juniortada/kossel-dragon-burner/images/effector_baixo.png

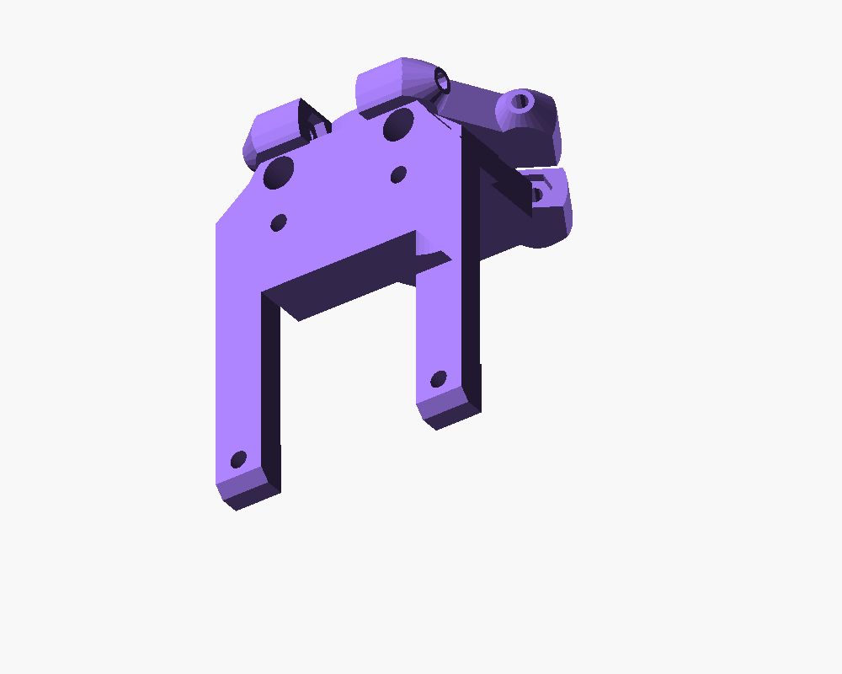
images/effector_baixo.png
