juniortada/kossel-dragon-burner/images/effector_cima.png

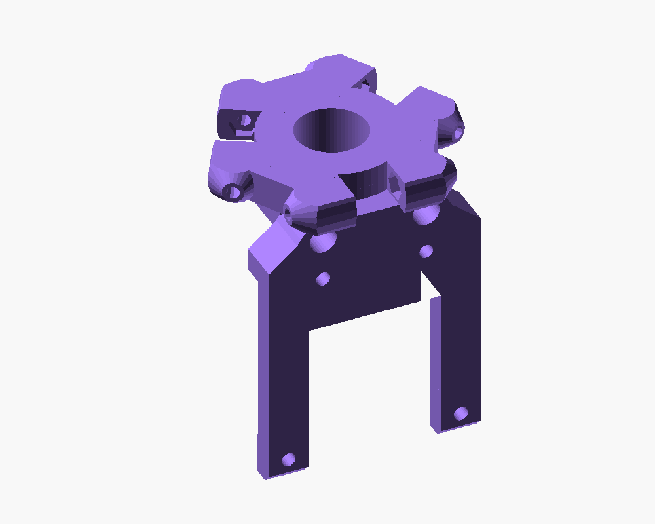
images/effector_cima.png
