juniortada/kossel-dragon-burner/images/impressao.png

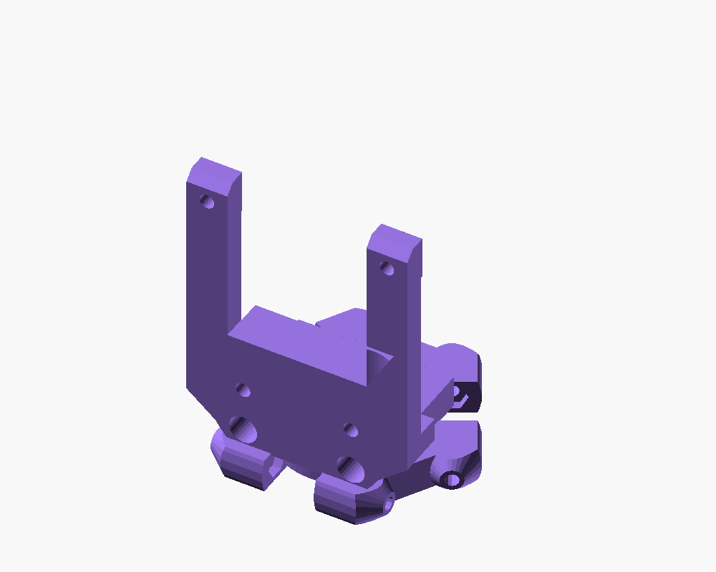
images/impressao.png
