juniortada/kossel-dragon-burner/parts/dragon_burner_bltouch_right.stl

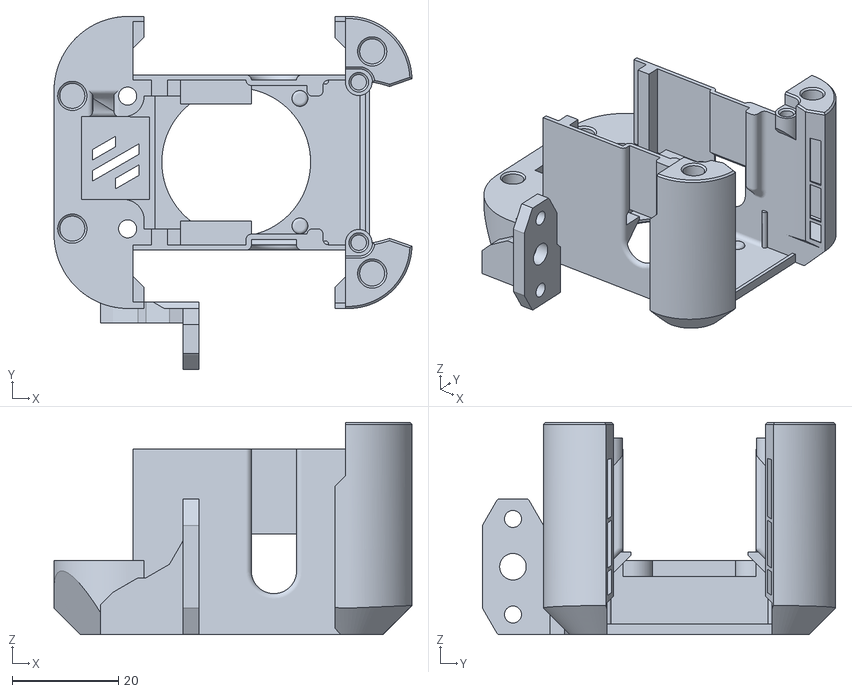
[picture p6: CAD file, 2026-11-02]
parts/dragon_burner_bltouch_right.stl
67.4 x 66.5 x 40.0
