juniortada/kossel-dragon-burner/parts/step/root__G2SA_Sherpa_Mount.stl

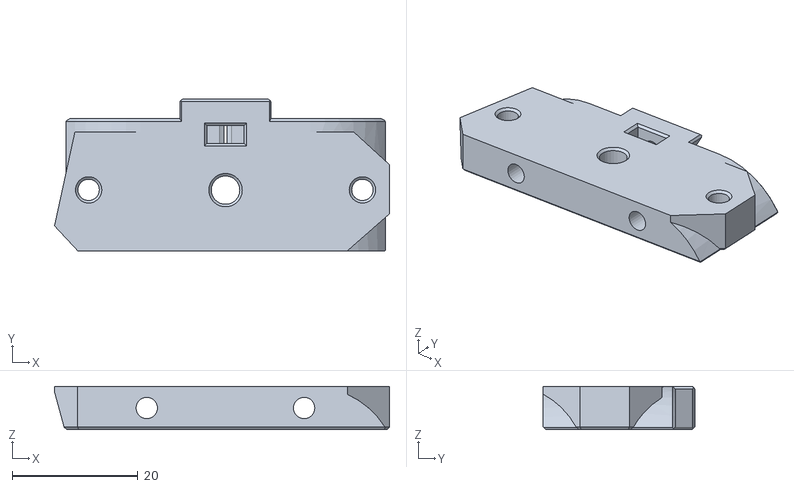
[picture p7: CAD file, 2026-11-02]
parts/step/root__G2SA_Sherpa_Mount.stl
53.2 x 24.1 x 6.90
