juniortada/kossel-dragon-burner/stl/effector_dragon_burner.stl

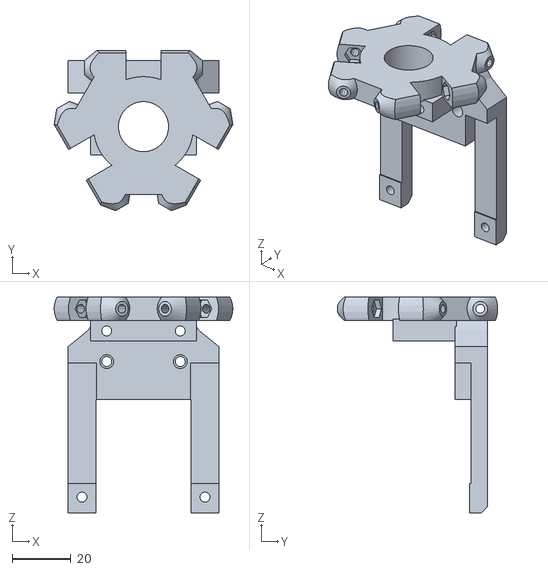
[picture p8: CAD file, 2026-11-02]
stl/effector_dragon_burner.stl
60.7 x 54.5 x 73.4
