juniortada/kossel-dragon-burner/parts/dragon_burner_bltouch_left.stl

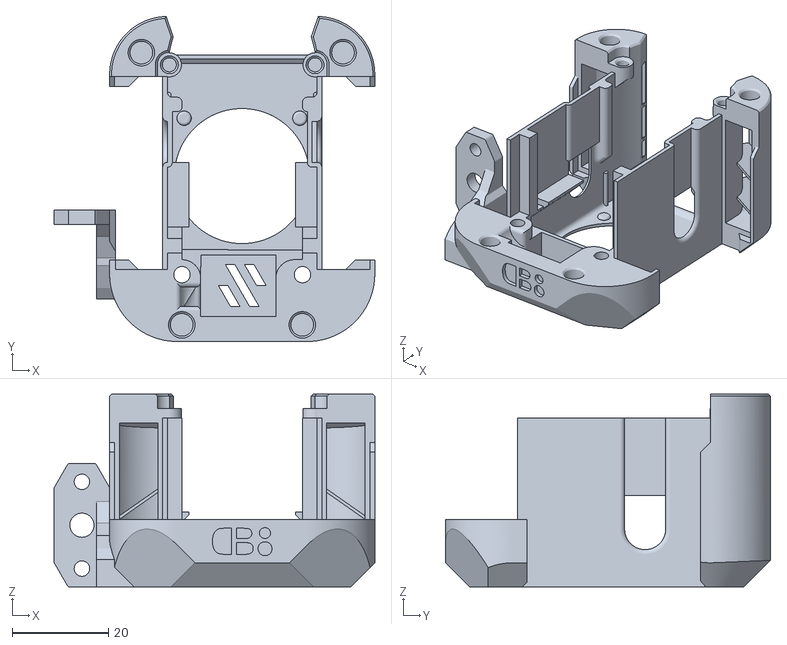
[picture p9: CAD file, 2026-11-02]
parts/dragon_burner_bltouch_left.stl
66.5 x 67.4 x 40.0
