juniortada/kossel-dragon-burner/parts/step/root__LGX_Lite_Mount.stl

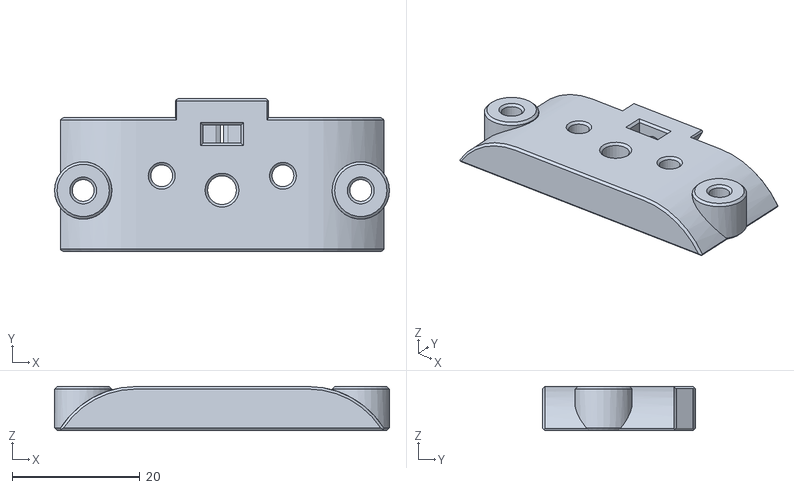
[picture p10: CAD file, 2026-11-02]
parts/step/root__LGX_Lite_Mount.stl
52.5 x 24.0 x 6.90
