juniortada/kossel-dragon-burner/parts/step/DFA_Mounts__Dragon_Mount_1.stl

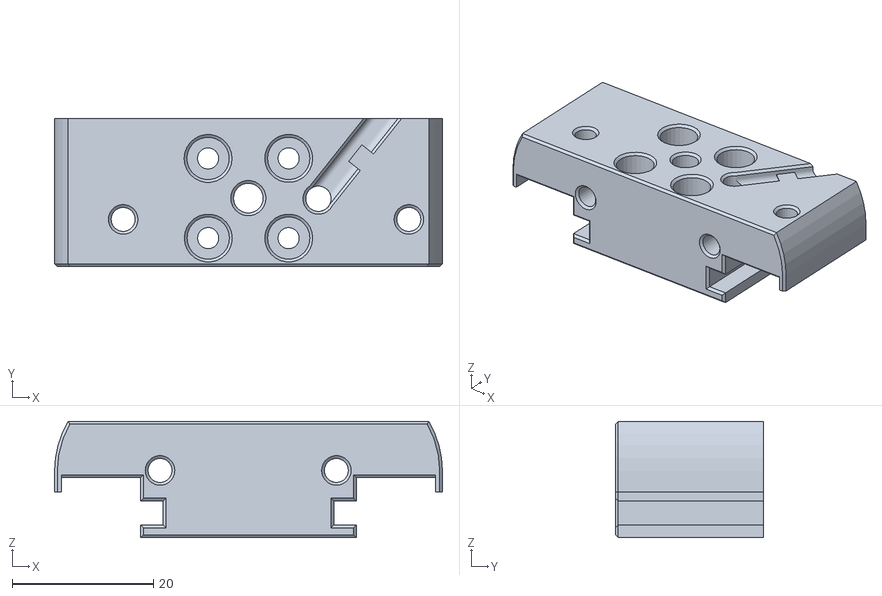
[picture p11: CAD file, 2026-11-02]
parts/step/DFA_Mounts__Dragon_Mount_1.stl
55.0 x 21.0 x 16.5
