juniortada/kossel-dragon-burner/stl/effector_dragon_burner_pc4_m10.stl

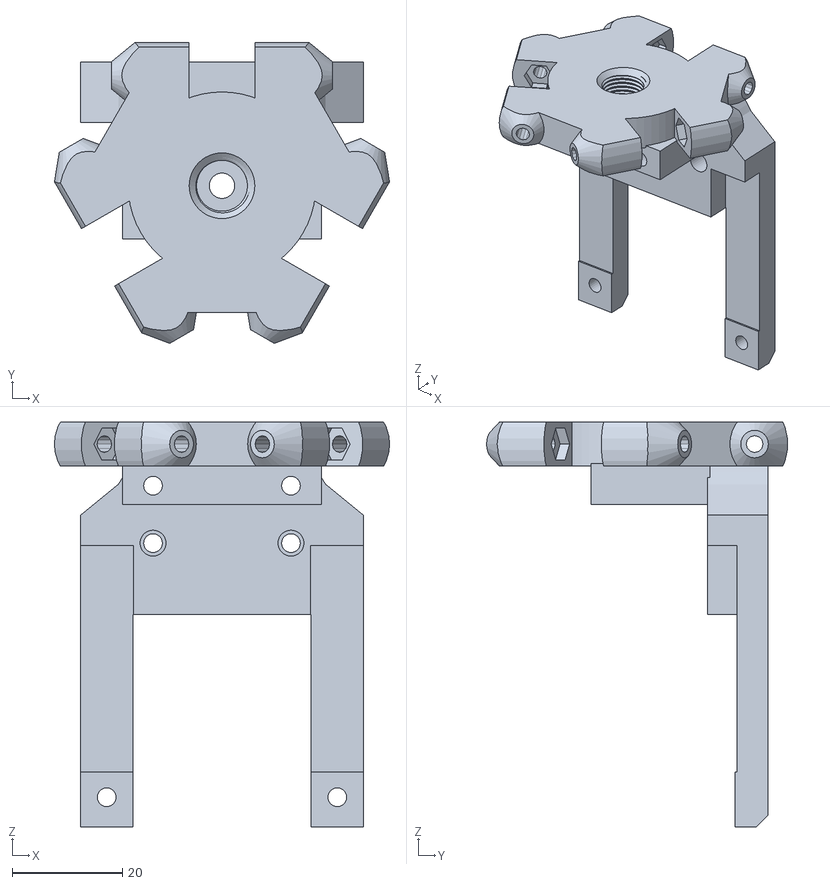
[picture p12: CAD file, 2026-11-02]
stl/effector_dragon_burner_pc4_m10.stl
60.7 x 54.5 x 73.4
