juniortada/kossel-dragon-burner/parts/step/Orbiter1.5_Mounts__V6_Mount_Front_1.stl

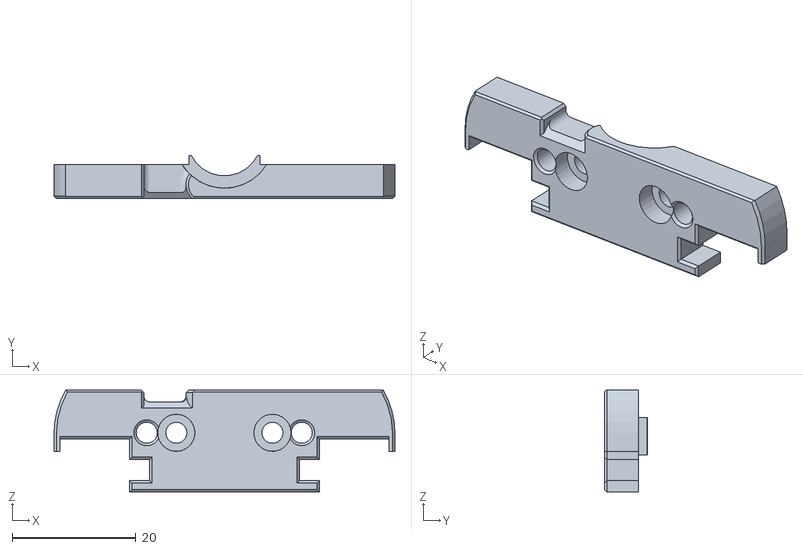
[picture p13: CAD file, 2026-11-02]
parts/step/Orbiter1.5_Mounts__V6_Mount_Front_1.stl
55.0 x 6.99 x 16.4
