juniortada/kossel-dragon-burner/parts/step/root__RoundTrip_Mount.stl

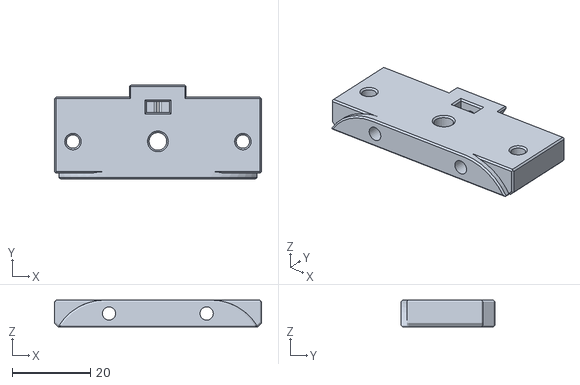
[picture p14: CAD file, 2026-11-02]
parts/step/root__RoundTrip_Mount.stl
53.0 x 24.1 x 6.90
