juniortada/kossel-dragon-burner/parts/step/Hotend_Mounts__V6_Mount_Rear.stl

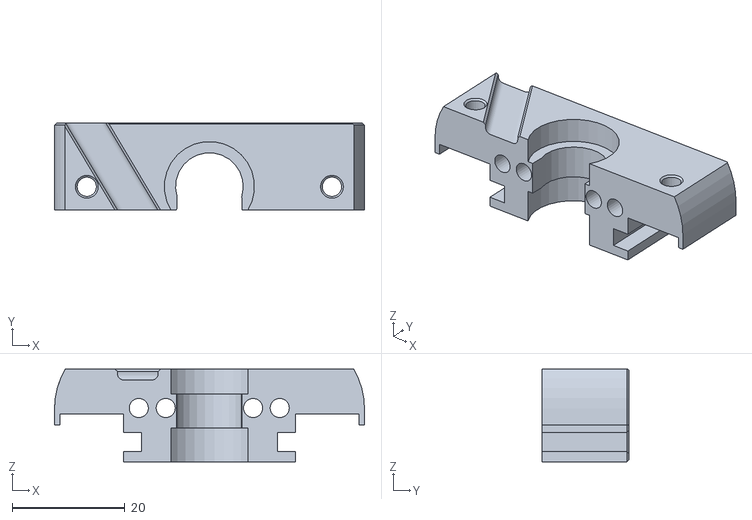
[picture p15: CAD file, 2026-11-02]
parts/step/Hotend_Mounts__V6_Mount_Rear.stl
55.0 x 15.5 x 16.4
