juniortada/kossel-dragon-burner/parts/step/Orbiter1.5_Mounts__Orbiter1.5_Mount_2.stl

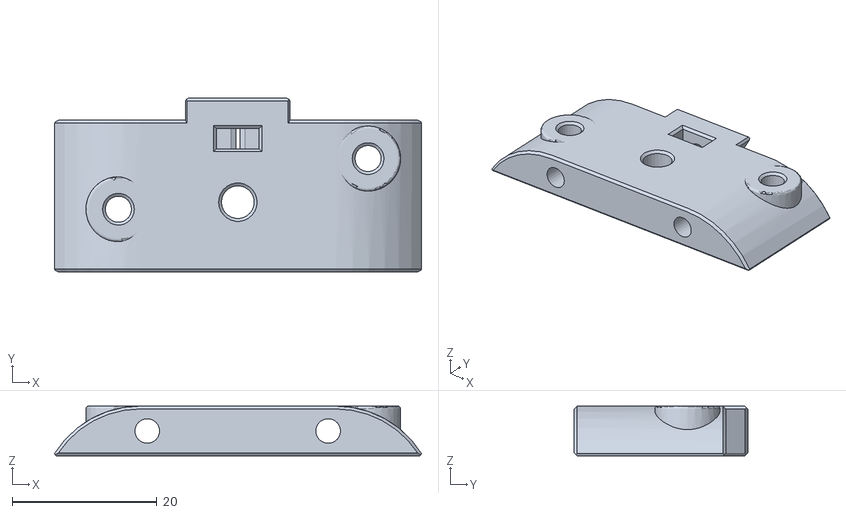
[picture p16: CAD file, 2026-11-02]
parts/step/Orbiter1.5_Mounts__Orbiter1.5_Mount_2.stl
50.7 x 24.0 x 6.90
