juniortada/kossel-dragon-burner/parts/step/Orbiter2_Mounts__RevoMicro_Mount.stl

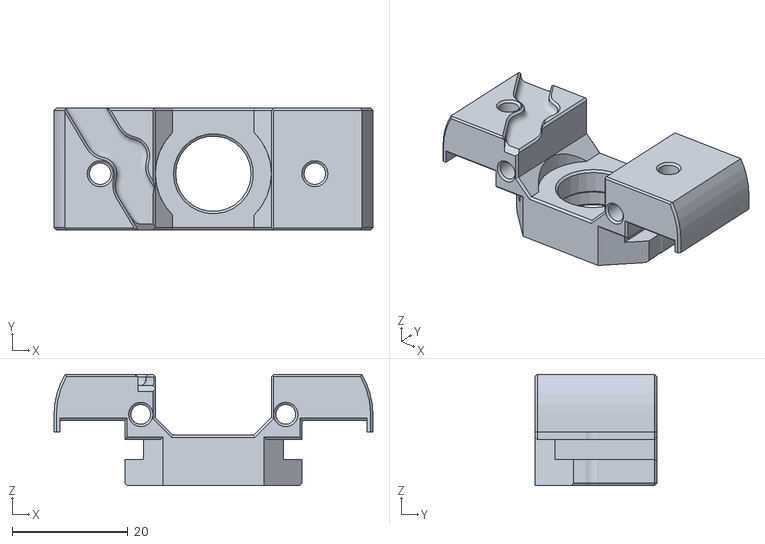
[picture p17: CAD file, 2026-11-02]
parts/step/Orbiter2_Mounts__RevoMicro_Mount.stl
55.0 x 21.0 x 19.1
