juniortada/kossel-dragon-burner/parts/step/Sherpa_Micro_Mounts__Sherpa_Micro_Mount.stl

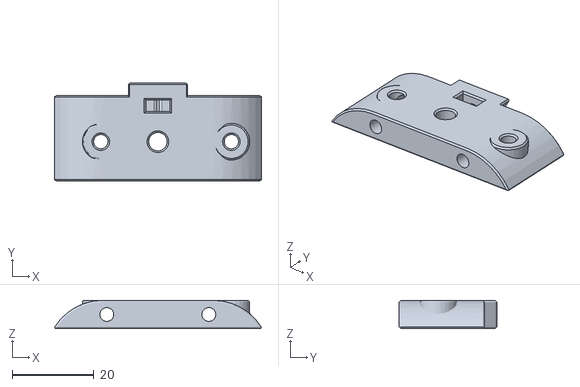
[picture p18: CAD file, 2026-11-02]
parts/step/Sherpa_Micro_Mounts__Sherpa_Micro_Mount.stl
50.7 x 24.0 x 6.90
