juniortada/kossel-dragon-burner/parts/step/root__Bowden_Mount_285.stl

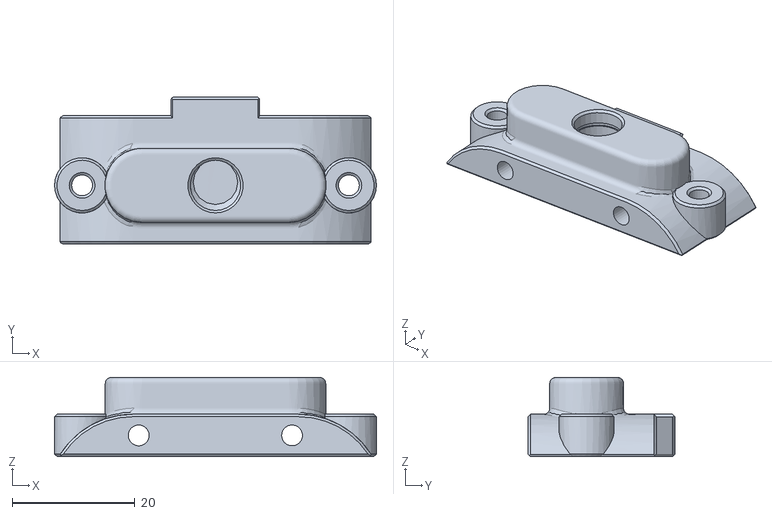
[picture p19: CAD file, 2026-11-02]
parts/step/root__Bowden_Mount_285.stl
52.5 x 24.0 x 12.9
