juniortada/kossel-dragon-burner/parts/step/root__WristWatch_BMG_Mount.stl

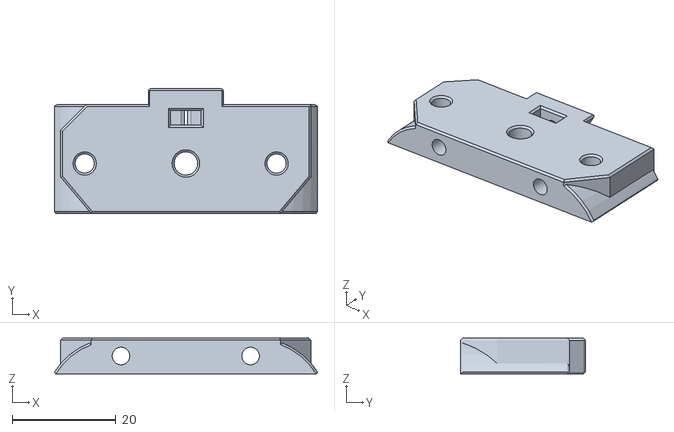
[picture p20: CAD file, 2026-11-02]
parts/step/root__WristWatch_BMG_Mount.stl
50.7 x 24.1 x 6.90
