juniortada/kossel-dragon-burner/parts/step/Orbiter1.5_Mounts__Dragon_Mount_2_1.stl

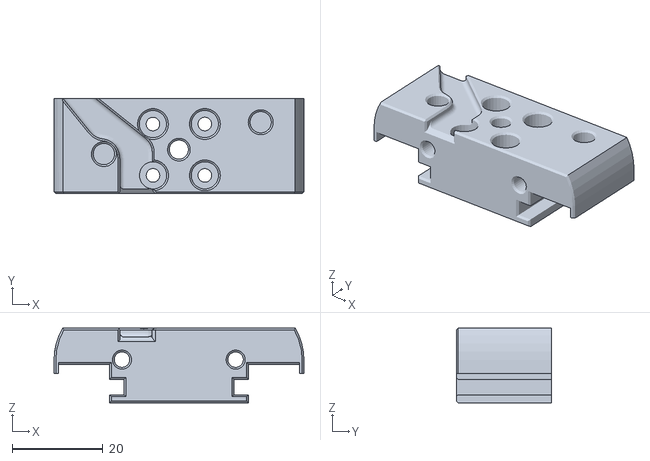
[picture p21: CAD file, 2026-11-02]
parts/step/Orbiter1.5_Mounts__Dragon_Mount_2_1.stl
55.0 x 21.0 x 16.5
