juniortada/kossel-dragon-burner/parts/step/root__Bowden_Mount_1.stl

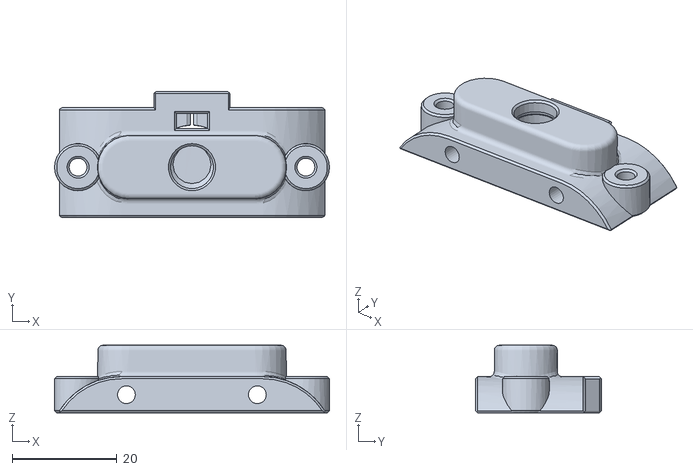
[picture p22: CAD file, 2026-11-02]
parts/step/root__Bowden_Mount_1.stl
52.5 x 24.0 x 12.9
