juniortada/kossel-dragon-burner/parts/step/root__Sherpa_Mini_Mount.stl

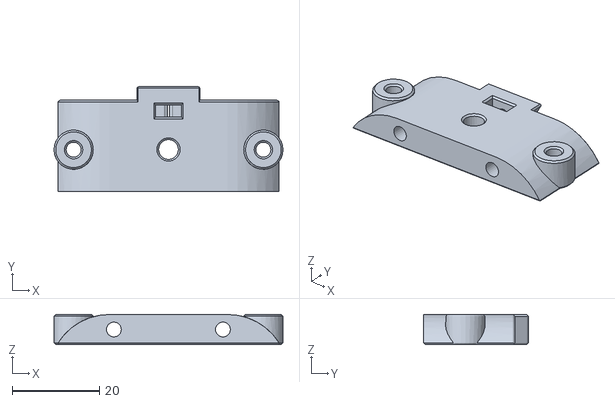
[picture p23: CAD file, 2026-11-02]
parts/step/root__Sherpa_Mini_Mount.stl
52.5 x 24.1 x 6.90
