juniortada/kossel-dragon-burner/parts/step/DFA_Mounts__DFA_Mount.stl

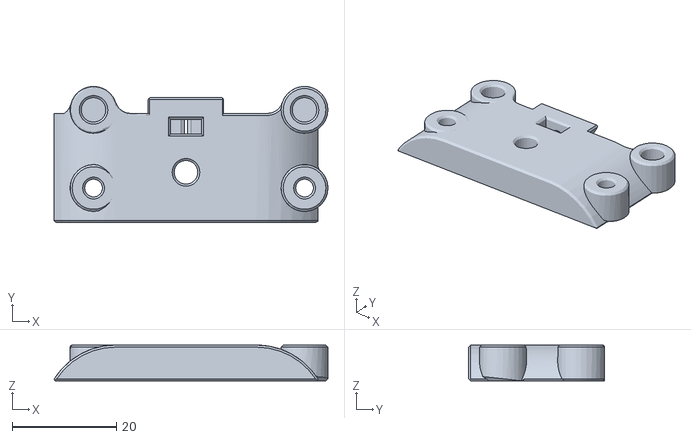
[picture p24: CAD file, 2026-11-02]
parts/step/DFA_Mounts__DFA_Mount.stl
52.6 x 26.1 x 6.90
