juniortada/kossel-dragon-burner/parts/step/Hotend_Mounts__Dragon_Mount.stl

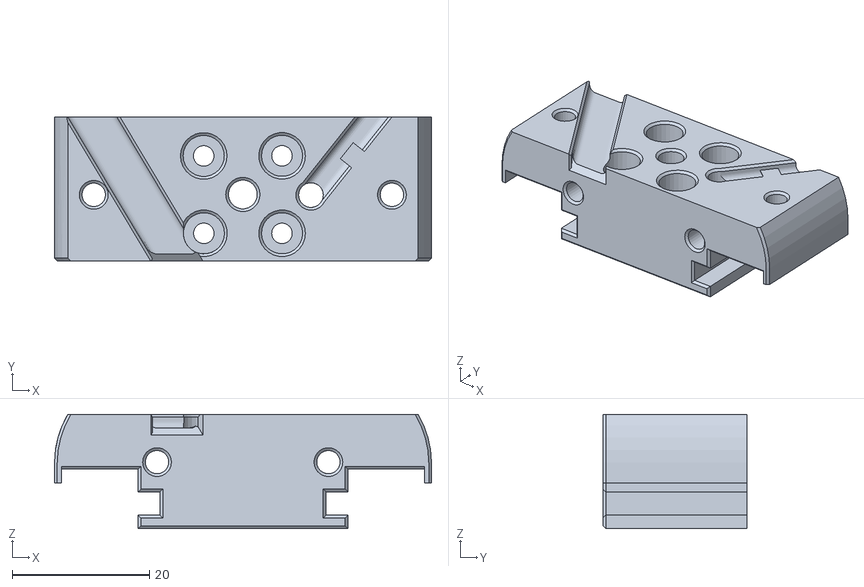
[picture p25: CAD file, 2026-11-02]
parts/step/Hotend_Mounts__Dragon_Mount.stl
55.0 x 21.0 x 16.7
