juniortada/kossel-dragon-burner/(list of files, cad)

Other CAD files:
stl/effector_dragon_burner_pc4_m6.stl
parts/step/Orbiter2_Mounts__Dragon_Mount_3.stl
parts/step/Sherpa_Micro_Mounts__Dragon_Mount_2.stl
parts/step/Orbiter2_Mounts__V6_Mount_Front_3.stl
parts/step/Sherpa_Micro_Mounts__V6_Mount_Back_1.stl
parts/step/Orbiter2_Mounts__Orbiter2_Mount_4.stl
parts/step/Hotend_Mounts__V6_Mount_Front.stl
parts/step/Orbiter1.5_Mounts__V6_Mount_Back.stl
parts/step/Sherpa_Micro_Mounts__V6_Mount_Front_2.stl
parts/step/root__G2SA_Orbiter_Mount.stl
parts/step/Orbiter2_Mounts__V6_Mount_Back_2.stl
