juniortada/kossel-dragon-burner/images/montagem_lateral.png

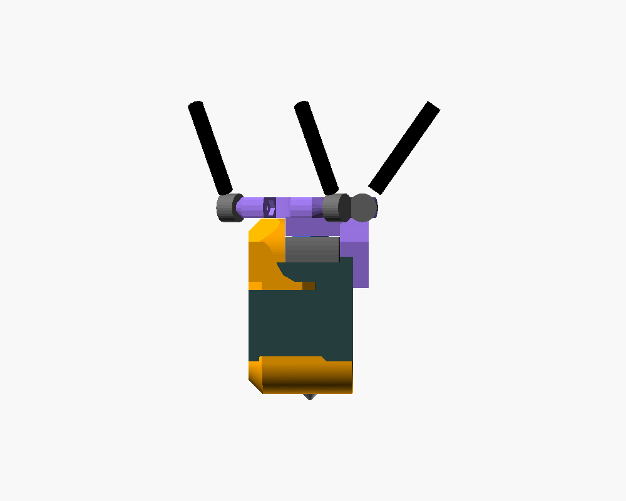
images/montagem_lateral.png
