juniortada/kossel-dragon-burner/images/montagem_traseira.png

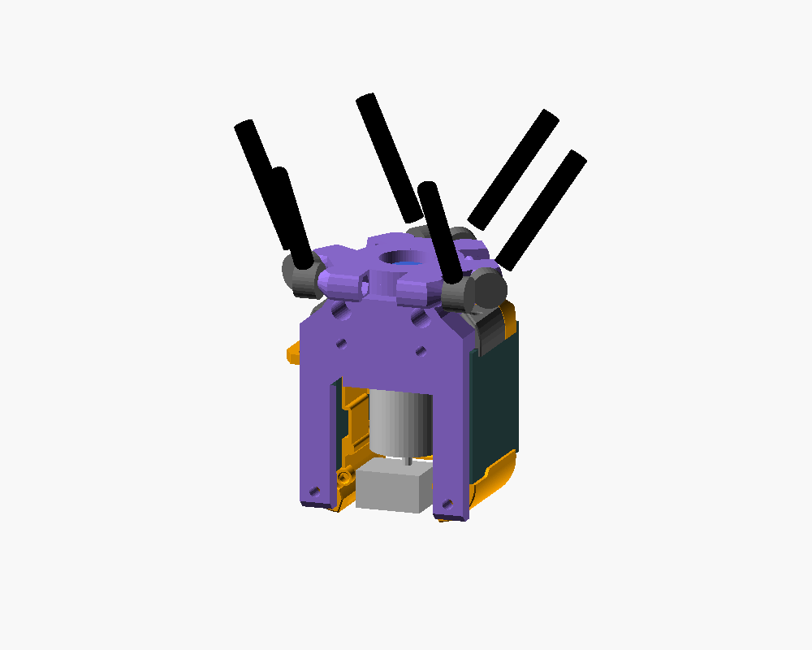
images/montagem_traseira.png
