juniortada/kossel-dragon-burner/(commit log)

2026-11-02 Add Kossel Mini effector for the Dragon Burner toolhead
2026-11-02 Widen the PTFE bore and drop the zip tie windows in the legs
